Nicolassalazar-pro/desktop-robot/body models/README.md

# Desktop Robot CAD source

This directory contains the editable and printable mechanical design for the
Desktop Robot chassis:

- native Autodesk Fusion archives (`.f3d`)
- printable mesh exports (`.stl`)
- the assembled print project (`.3mf`)

## License notice

Copyright (c) 2025-2026 Nick Salazar.

These project-authored hardware design files are licensed under the
**CERN Open Hardware Licence Version 2 - Strongly Reciprocal
(CERN-OHL-S-2.0)**.

Full license text:
[`../LICENSES/CERN-OHL-S-2.0.txt`](../LICENSES/CERN-OHL-S-2.0.txt)

Source location:
<https://github.com/Nicolassalazar-pro/desktop-robot/tree/main/body%20models>

If you convey a modified design or a product made from it, follow the source,
notice, and reciprocity requirements in CERN-OHL-S-2.0.

## Fusion project archive

`Tank - Fusion Source/` contains the six native designs from the original
Fusion project:

- Buttons
- Head Mount Clip
- robot stand
- Screen Head Mount 1
- Screen Head Mount 2
- Support Bar
