Nicolassalazar-pro/desktop-robot/datasheets/Board_Hardware_Callouts.jpg

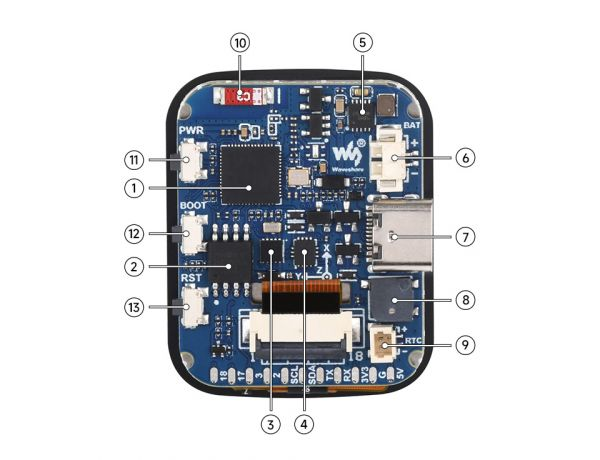
datasheets/Board_Hardware_Callouts.jpg
