Nicolassalazar-pro/desktop-robot/tools/assets/official-garage/horizontal_black.png

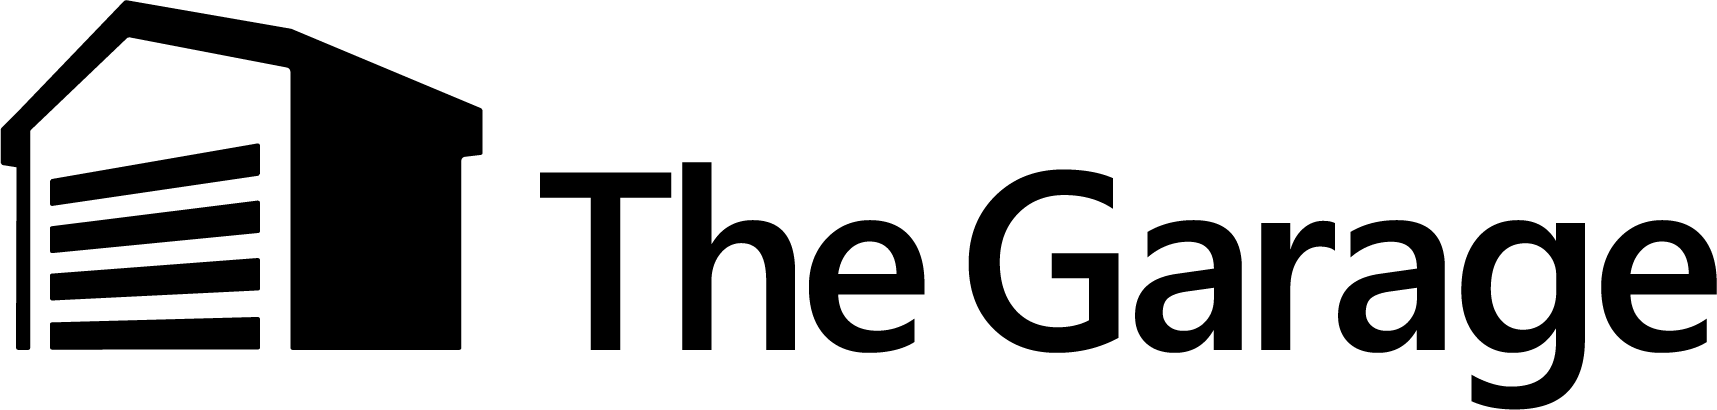
tools/assets/official-garage/horizontal_black.png
