Nicolassalazar-pro/desktop-robot/tools/assets/official-garage/vertical_black.png

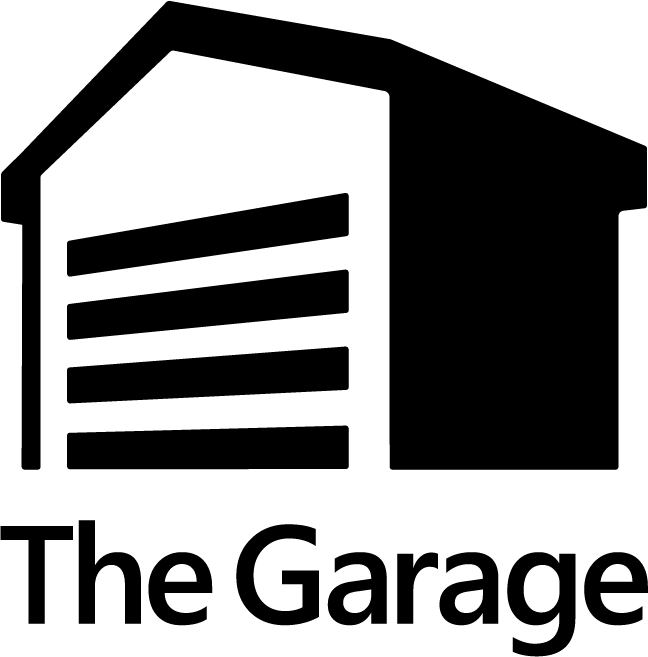
tools/assets/official-garage/vertical_black.png
