Nicolassalazar-pro/desktop-robot/body models/Full Parts Print.3mf

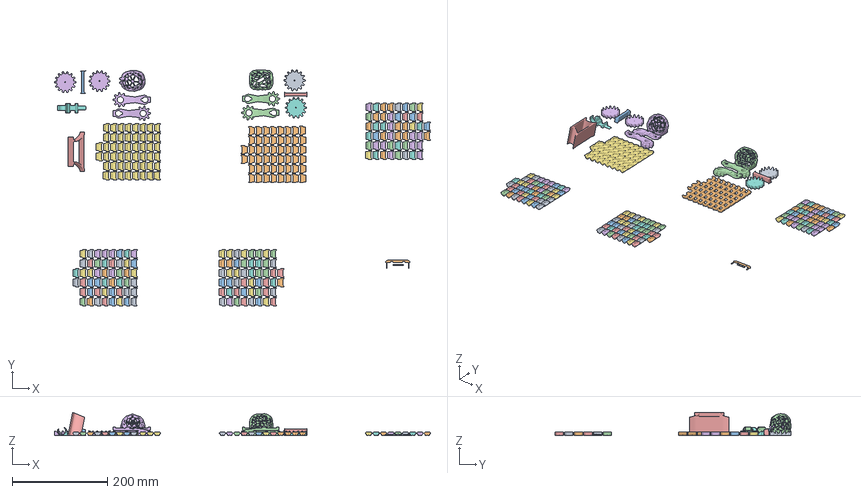
[picture p8: CAD file, 2026-08-07]
body models/Full Parts Print.3mf
788.2 x 495.1 x 49.0 mm
Drive Wheel.stl x 2
Track Organic Pads.stl x 50
Track Bar Pads.stl x 50
Track Choco Pads.stl x 50
Support Bar.stl x 2
Assembly x 4
Robot Stand.stl
Head Clip.stl
Buttons.stl
Support Bar 2.stl
