Nicolassalazar-pro/desktop-robot/body models/Support Bar 2.stl

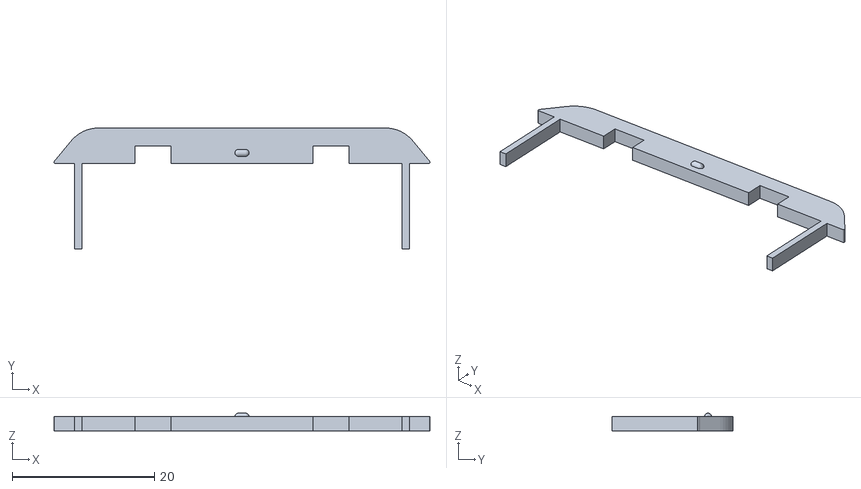
[picture p9: CAD file, 2026-08-07]
body models/Support Bar 2.stl
52.8 x 17.0 x 2.50
