Nicolassalazar-pro/desktop-robot/body models/Mesh Head 1.stl

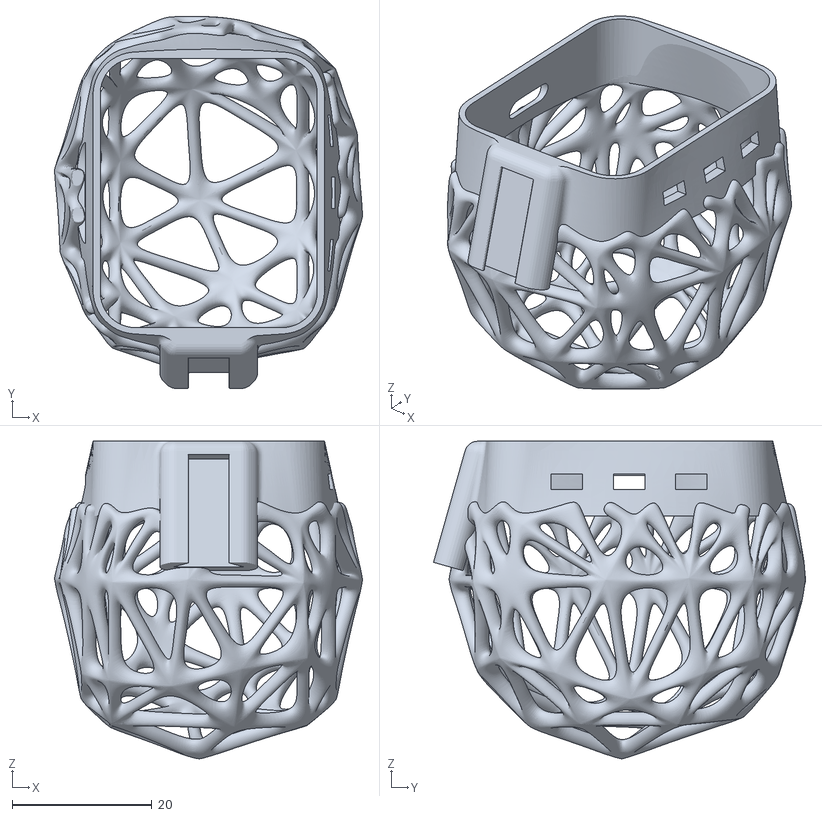
[picture p10: CAD file, 2026-08-07]
body models/Mesh Head 1.stl
44.0 x 53.2 x 45.4
