Nicolassalazar-pro/desktop-robot/body models/Buttons.stl

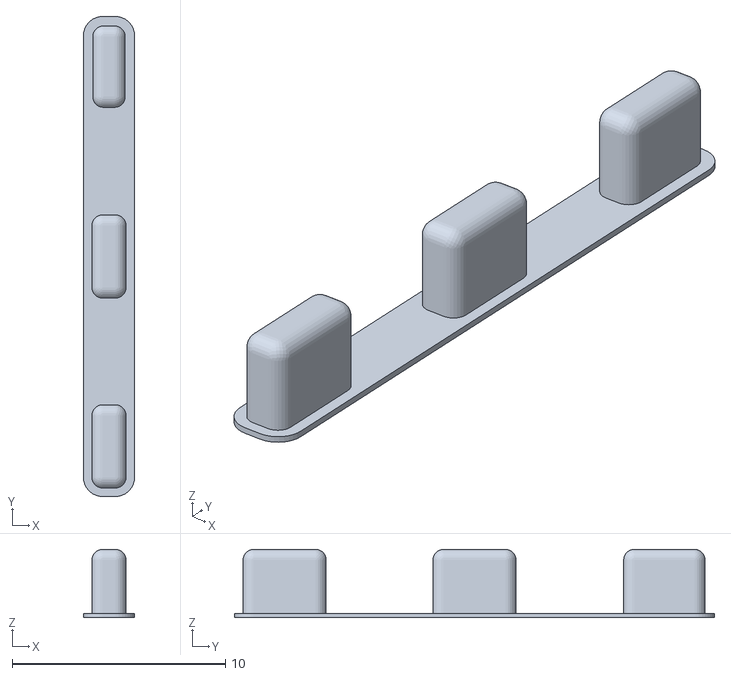
[picture p13: CAD file, 2026-08-07]
body models/Buttons.stl
2.40 x 22.5 x 3.20
