Nicolassalazar-pro/desktop-robot/body models/Track Choco Pads.stl

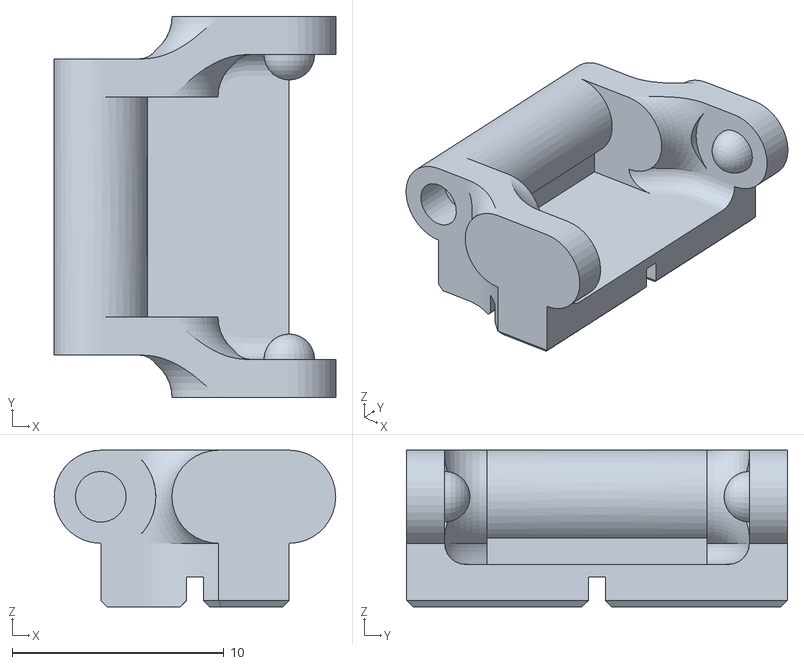
[picture p14: CAD file, 2026-08-07]
body models/Track Choco Pads.stl
13.3 x 18.0 x 7.40
