Nicolassalazar-pro/desktop-robot/body models/Drive Wheel.stl

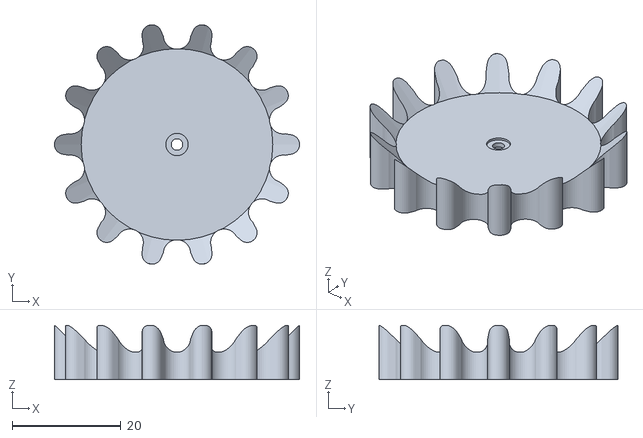
[picture p15: CAD file, 2026-08-07]
body models/Drive Wheel.stl
45.0 x 44.0 x 10.00
