Nicolassalazar-pro/desktop-robot/body models/Support Bar.stl

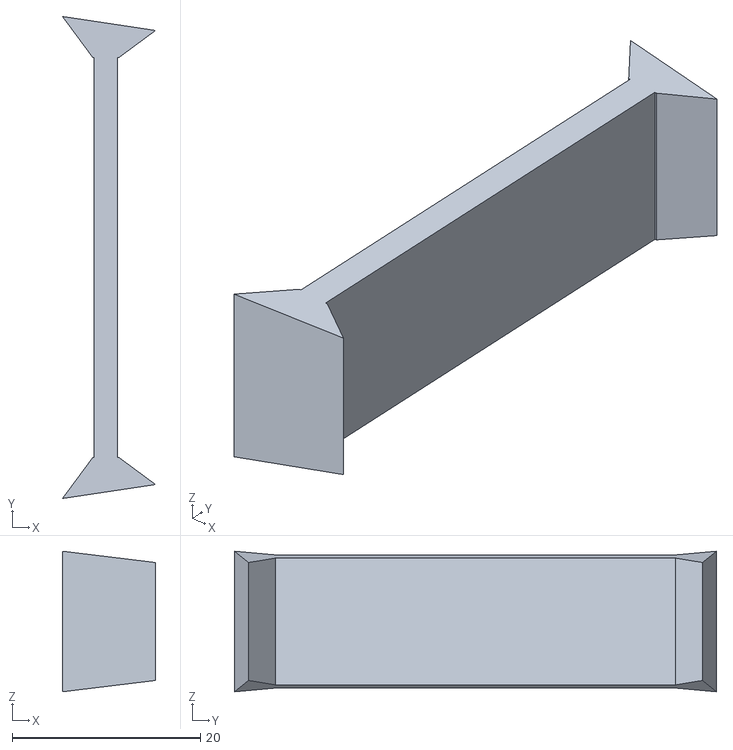
[picture p16: CAD file, 2026-08-07]
body models/Support Bar.stl
9.89 x 51.2 x 14.9
