Nicolassalazar-pro/desktop-robot/body models/Rear Road Wheel and Rail Guide.stl

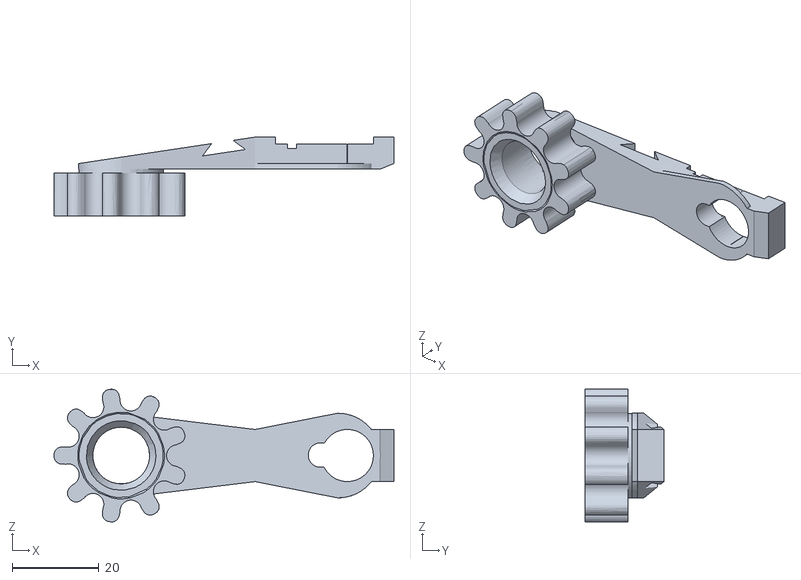
[picture p17: CAD file, 2026-08-07]
body models/Rear Road Wheel and Rail Guide.stl
78.3 x 18.2 x 30.6
