Nicolassalazar-pro/desktop-robot/body models/Head Clip.stl

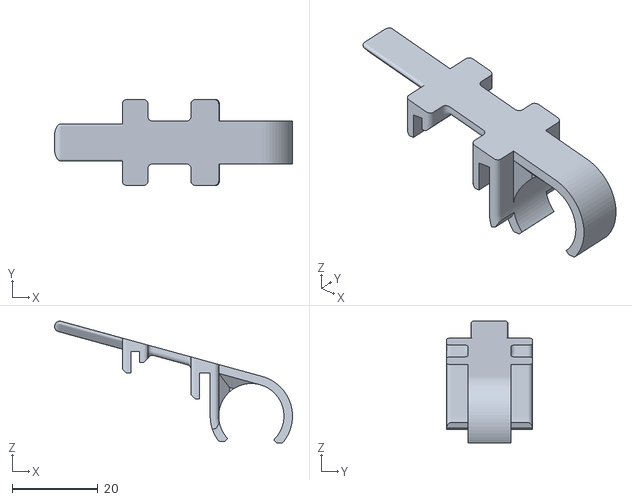
[picture p18: CAD file, 2026-08-07]
body models/Head Clip.stl
55.5 x 20.0 x 28.4
