Nicolassalazar-pro/desktop-robot/body models/Mesh Head 2.stl

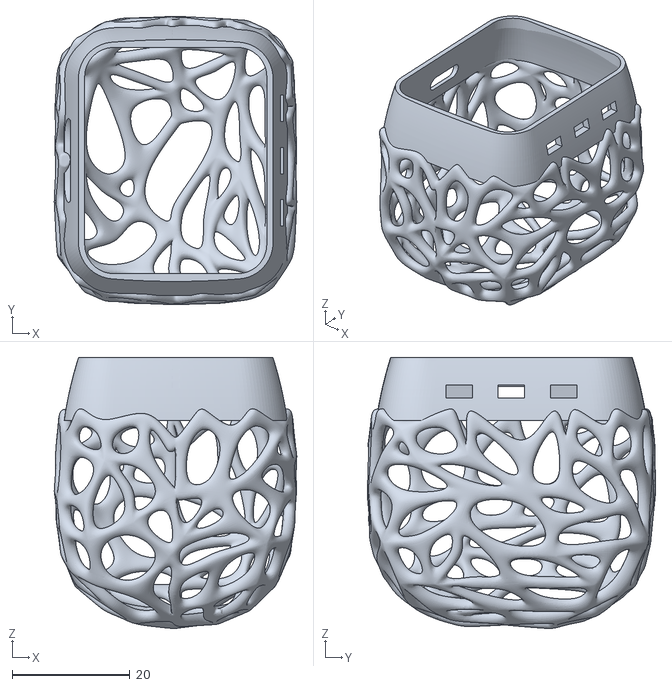
[picture p19: CAD file, 2026-08-07]
body models/Mesh Head 2.stl
41.3 x 49.0 x 46.1
