Nicolassalazar-pro/desktop-robot/body models/Robot Stand.stl

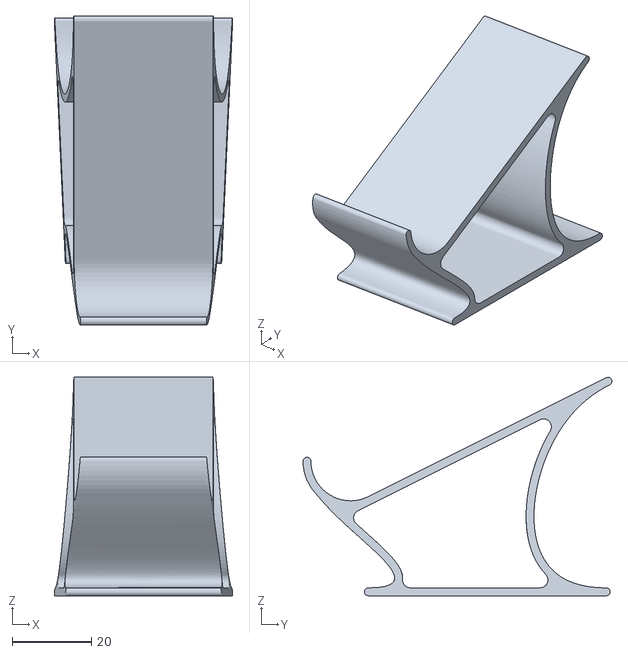
[picture p20: CAD file, 2026-08-07]
body models/Robot Stand.stl
45.0 x 77.9 x 55.1
