Nicolassalazar-pro/desktop-robot/(list of files, cad)

Other CAD files:
body models/Tank - Fusion Source/Buttons.f3d
body models/Tank - Fusion Source/Head Mount Clip.f3d
body models/Tank - Fusion Source/Screen Head Mount 1.f3d
body models/Tank - Fusion Source/Screen Head Mount 2.f3d
body models/Tank - Fusion Source/Support Bar.f3d
body models/Tank - Fusion Source/robot stand.f3d
