Nicolassalazar-pro/desktop-robot/src/override_html.h

// override_html.h
// Declaration for the PROGMEM-backed Override phone UI HTML payload.
// Definition lives in override_html.cpp so it does not clutter main.cpp.
#pragma once

#include <Arduino.h>

extern const char OVERRIDE_HTML[] PROGMEM;
