Nicolassalazar-pro/desktop-robot/tools/lcd_preview.py

"""Render the robot's LCD screens on the host, without flashing.

Every LCD layout bug so far has cost a full build-flash-look cycle, and one of
them (the step dots overlapping the password row by 2 px) was caught only
because the vertical budget happened to get checked by hand. This renders the
same screens to PNG so layout can be reviewed, and overlaps detected
automatically, before anything touches the panel.

It is a LAYOUT preview, not a pixel-exact emulator. That distinction matters:

  exact    screen size, element Y positions, text metrics, QR module count and
           scale, and therefore every overlap and every overflow -- which is
           the entire class of bug this exists to catch
  close    the GFX 5x7 glyph shapes are approximated by a system font
  ignored  colour depth (RGB565 banding) and SPI timing

The pull-down pairing sheet (src/sheet_transition.h) is previewed on the same
terms, one honest layer at a time:

  exact    kThresholdPct is parsed from the header, so if the commit point
           moves in firmware this filmstrip moves with it. The row-split
           composite (rows [0..sheetY) = card, rows [sheetY..H) = face) is
           the model spelled out in the header, not a re-modelled copy.
  close    the face is a labelled geometric placeholder, not the mascot
           bitmap; the pairing card is a labelled placeholder because the
           card's real layout is not yet in firmware. Both are drawn so they
           cannot be mistaken for the shipped artwork.
  ignored  rubber-band overshoot (only 0..100% is shown, not [-h/3..4h/3])
           and the release-by-projected-velocity decision (this shows sheet
           POSITION, not the gesture that produced it -- for that model see
           the header itself)

Positions and constants are PARSED FROM src/main.cpp, src/sheet_transition.h,
and platformio.ini rather than duplicated here, so the preview cannot silently
drift away from the firmware. If a y= value or a constexpr moves in the C++,
this follows it. If parsing fails it says so loudly instead of quietly
rendering a lie -- a preview that overstates itself is worse than none.

Usage:
    python tools/lcd_preview.py                    # render everything
    python tools/lcd_preview.py --sheet-only       # just the sheet filmstrip
    python tools/lcd_preview.py --out build/lcd    # choose output directory
    python tools/lcd_preview.py --check            # overlap check only, no PNGs

Exit code is non-zero if any screen has an overlap or overflows the panel, so
this can gate a build.
"""

from __future__ import annotations

import argparse
import pathlib
import re
import sys
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
