Nicolassalazar-pro/desktop-robot/(commit log)

2026-08-07 Baseline: working firmware at first commit
    The project had no version control until now. This commits the current
    working state as-is, before any refactoring, so every later change is
    reviewable and revertable.
    State at this commit:
    - ESP32-S3 Waveshare Touch-LCD-1.69 firmware; 16 LCD faces, 3 movement
    gestures, on-device mood-melody generator (happy/sad/confused), softAP
    web control app, IMU turn measurement with coast compensation.
    - 13 host test suites passing; pio build green.
    Recent debugging (see docs/ and HARDWARE.md):
    - LCD SPI dropped 80 -> 40 MHz. 80 MHz violates the ST7789V2 TSCYCW
    minimum of 16 ns (62.5 MHz ceiling), measured from the datasheet.
    - Added panel read-back vi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
2026-08-08 docs: recover 14 months of project history from 66 checkpoints
    The project history lived only in Copilot CLI session state. The current
    session had 3 of 67 checkpoints loaded, and that gap cost real time: two
    bugs were re-debugged from scratch this week that were already documented.
    PROJECT-HISTORY.md (1438 lines) distils session ee90215e:
    - Timeline across 28 eras, DeskNotif wire protocol through mood melodies
    - 26 decisions with the reasoning that produced them
    - 43 approaches ALREADY TRIED AND REJECTED, with why each failed
    - Measured hardware constants, flagged MEASURED vs ASSUMED
    - 8 open bugs, incl. full detail on the WiFi netstack 12308 fault
    - Working agreements, glossary, and a lis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
2026-08-08 fix(wifi): stop AP teardown corrupting the lwIP netif chain
    softAPdisconnect(wifioff=true) shuts the WiFi driver down inside the
    call, and that shutdown emits a spurious AP_START -> AP_STOP pair with:
    E wifi_init_default: netstack cb reg failed with 12289
    The driver is re-registering lwIP netif callbacks against a chain it is
    concurrently destroying. The result is an AP that beacons and hands out
    DHCP leases while routing nothing to AsyncWebServer - the phone joins,
    gets an IP, and every HTTP request times out.
    Open since checkpoint 062 (recorded there as 12308; same fault, the code
    varies). Two earlier attempts failed because both left wifioff=true:
    - removing WiFi.mode(WIFI_OFF) +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
2026-08-08 fix(serial): never write to USB CDC without FIFO space
    This is the black screen. It was never a display fault: the loop task
    blocked on a USB CDC write, stopped feeding the watchdog, and TASK_WDT
    reset the board ~5 s later. The screen going dark was the reset.
    The previous attempt gated periodic output on a host being attached.
    That was necessary but not sufficient, and the measurement that proved
    it is the useful part:
    port CLOSED, 150 s idle -> uptime 19s -> 176s, no reset
    port OPEN while I interacted -> reset
    An attached host is not necessarily a host that is reading. A script
    that opens the port, writes a command, sleeps, then reads leaves the
    FIFO to fill exactly as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
2026-08-08 build: pin dependencies exactly so the build is reproducible
    platformio.ini declared ^ and ~ ranges and PlatformIO has no lockfile, so
    the manifest did not determine what got built. Not theoretical - the tree
    on disk had already floated:
    declared ESPAsyncWebServer-esphome@^3.3.0 -> resolved 3.4.0
    declared ArduinoJson@^7.1.0 -> resolved 7.4.3
    declared GFX Library for Arduino@~1.3.7 -> resolved 1.3.9
    That matters here because three recent fixes depend on the exact
    AsyncTCP/AsyncWebSocket callback contract: refusing unauthorised upgrades
    at the HTTP handshake (closing inside WS_EVT_CONNECT crashed the board),
    reaping dead clients after 8 s (a phone leaving Wi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
2026-08-08 fix(safety): cancel a running gesture when drive control is force-reset
    RELY-3, and a regression I introduced earlier today.
    Fixing "gestures never move" required narrowing the abort gate in
    serviceMovementGesture from `state() != SafeOff` to only Active/Manual/
    Shutdown, because a connected-but-neutral web session sits at ArmedOff
    and was cancelling every gesture on its first tick.
    That over-corrected. resetDriveControl() puts the session in SafeOff, and
    SafeOff is no longer in the abort set - so a transport fault
    (MalformedControl, ProtocolFailure, TransportFailure, WS queue overflow)
    powered the rail down and the very next loop tick re-energised it, because
    serviceMovementGesture writes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
2026-08-08 fix(ui): make STOP a latched mode, and look like an emergency control
    DSGN-1 (critical) and DSGN-2, plus DSGN-7.
    STOP was a momentary write: zero curL/curR, send one frame. That does not
    survive the posture the user is actually in when they press it - one thumb
    still resting on a stick. The next pointermove reassigns curL/curR from the
    finger position and the 30 Hz sender re-arms drive within one tick, so the
    wheels stop for a single frame and then start again for no visible reason.
    STOP is now a mode:
    - stopLatched forces every outgoing control frame to zero, gated in
    sendCtrl itself so no stray handler can route around it
    - both stick pointermove handlers ignore a finger that was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
2026-08-08 fix(ws): never close a websocket client from the AsyncTCP callback
    RELY-1 and RELY-2.
    Closing a client from inside an AsyncTCP callback re-enters that client's
    own teardown. It is the pattern that crashed this board with INT_WDT and
    no backtrace, and the code comment above one of the call sites already
    named it "the prime suspect" and "a classic use-after-free".
    That was fixed for the AUTH path by refusing unauthorised upgrades at the
    HTTP handshake, before any client object exists. But auth is only one
    reason to reject an upgrade. Eight other close() calls remained on the
    AsyncTCP task: quarantined ingress, owner-busy, activation-faulted,
    enqueue-failure rollback, owner-token TOCTOU rollb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
2026-08-08 docs+fix: document the whole command surface, harden token compare
    DOCS-1/2/3/5/6, READ-2, RELY-7, RELY-8.
    `help` documented 25 of the 48 commands dispatchCommand actually handles.
    Everything built to diagnose this week's faults - lcdprobe, lcdpush,
    lcdbus, lcdspi, crash, sense - was reachable only by reading the source.
    All 24 missing commands are now listed and grouped.
    README:
    - the tethered-drive rule is now the first thing after the title, with
    the arm/unplug/press/read-back workflow spelled out. It was previously
    buried, and it is the rule most likely to damage hardware.
    - points at docs/PROJECT-HISTORY.md as the starting point, because two
    bugs were re-debugged this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
2026-08-08 perf: free 45 KB of internal RAM held for an off-by-default feature
    PERF-1.
    g_eyeRegionBackup was a static .bss array sized to the worst-case eye
    rectangle: 191 x 120 x 2 B = 45,840 bytes of INTERNAL SRAM. Confirmed from
    the linker map, not calculated:
    .bss._ZN12_GLOBAL__N_117g_eyeRegionBackupE 0xb310 = 45840
    Its only consumer is applyHeadSympathyShift(), which does nothing unless
    g_headShiftXDiv/YDiv are non-zero - and both default to 0. The feature is
    off until somebody types `headgain`. So the board permanently reserved
    45 KB of fast internal RAM, about 44% of everything it reported using, for
    a feature that was not running.
    Now allocated lazily in PSRAM on first use. PSRAM is th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
2026-08-08 fix(ws): stop the transport reaper crashing and killing live sessions
    Five defects, all on the AP/WebSocket path, all found by auditing my own
    changes rather than by patching symptoms. Four of the five were introduced
    earlier in this session BEFORE the git baseline, so they never appeared in
    any diff -- which is why incremental patching kept missing them.
    1. The stale-owner reaper's liveness clock was never armed.
    g_lastControlEventMs starts at 0 and was only written when a control
    FRAME arrived. Nothing set it when a client was ADMITTED. A client
    admitted at millis()=90000 was therefore instantly judged silent for
    90 s, and the reaper killed it on the very next loop pass, befo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
2026-08-08 fix(webapp): reconnect when telemetry goes silent + correct the RELY findings
    An open socket is not a working link.
    The firmware deliberately no longer closes a client whose transport ownership
    was revoked -- closing one from a stale data path was a use-after-free that
    reset the board (R45). But the web app only reconnected from `ws.onclose`, so
    with the close gone it had no way to notice it had been evicted: the socket
    stays open, every frame is ignored, and the UI sits on "live" forever.
    Reported as "im connected to the network but it wont respond to the controller".
    The robot streams telemetry at 5 Hz, so silence is a reliable liveness signal
    in the other direction. The app now tracks t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
2026-08-11 refactor: stop [DEBUG-DELETE] lying about shipping code, extract the web app
    READ-1, READ-3, READ-4. No functional change: build RAM and Flash are
    bit-for-bit identical to baseline and 13/13 host suites pass.
    READ-1 -- [DEBUG-DELETE] was being used with two contradictory meanings. On the
    mood-name overlay it accurately means "scratch, strip before ship". On the
    battery meter and the entire Override phone UI it wrapped permanent,
    user-facing, load-bearing features. One banner literally read "Remove this block
    + all matching // [DEBUG-DELETE] lines before ship." over the battery meter,
    which PROJECT-HISTORY fixes as permanent behaviour (D19). Directly below the
    Override banner sit the SHIPPED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
2026-08-11 refactor: table-dispatch the serial console, generate help from the table
    READ-5 / split Phase B. Mechanical move, no behaviour change.
    RAM 57,624 B -> 57,624 B (0 delta)
    Flash 1,198,917 B -> 1,196,845 B (-2,072 B)
    memory_order_* count 248 -> 248 (unchanged)
    help output byte-identical
    dispatchCommand was an ~1,830-line if/strcmp/return chain over 48 commands,
    with printHelp a hand-maintained duplicate of that list. It had already drifted
    badly once -- READ-2 found help was hiding ~17 real commands, including the
    load-bearing panel diagnostics that the person debugging a wedged screen most
    needs. Fixing the list by hand does not stop it drifting aga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
2026-08-11 wave 3: legible pairing screen, gated logs, 3 more suites, SEC-1
    Three parallel agents plus a read-only security pass.
    RAM 57,624 -> 57,640 B (+16, four new globals)
    Flash 1,196,845 -> 1,198,137 B (+1,292, mostly comments and the two screens)
    memory_order_* 248 -> 248 (unchanged)
    suites 14 -> 16 native, 210 -> 214 python, exit 0
    OPERATOR-FACING
    DSGN-6. The pairing screen showed a QR and nothing else, with SSID and password
    at 8-pixel type. Added an instruction line and put the credentials at size 2,
    with an adaptive fallback to size 1 if a longer SSID would overflow 240 px. The
    QR payload and scale are UNCHANGED -- it is v4-M at ~67% capacity and the QRCode
    libr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
2026-08-11 feat(lcd): tell the operator the pairing flow has two steps, and which way it moves
    Applies three new design-craft sections (6a swipe choreography, 6b motion under
    a watchdog, 18 behavioural psychology) to the QR pairing flow. Sources: Kole
    Jain's swipe-interaction and micro-animation breakdowns, and a UX-psychology
    survey covering choice overload, goal-gradient, reciprocity, IKEA effect, loss
    aversion and anchoring.
    THE ACTUAL PROBLEM
    Pairing is two steps -- join the Wi-Fi, then open the control page -- and nothing
    said so. You scanned the first code, the screen changed, and there was no way to
    tell whether that was the end of it or whether something else was expected. The
    goal-gradient l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
2026-08-11 diag: time the touch poll and the loop pass, in RTC memory
    Instrumentation only. No behaviour change, no fix attempted -- the TASK_WDT
    stall is being diagnosed before anything is built on top of the touch path.
    WHY THIS SHAPE
    The event resets the board, so anything in normal RAM dies with it, and the
    serial line is the one channel we already know can be complicit (a full USB CDC
    FIFO was itself a stall cause earlier this week). The counters therefore live in
    RTC memory beside the existing breadcrumb, and the failed run's numbers are
    printed at the NEXT boot before setup can overwrite them.
    Recording the touch poll AND the whole loop pass is the point. A watchdog reset
    proves only that the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
2026-08-11 diag: capture power and motion state at the worst touch poll
    Still instrumentation only. No fix, no behaviour change.
    The stall cannot be reproduced on demand, so the goal shifts: make the ONE
    occurrence we eventually get sufficient to settle the question, rather than
    merely confirming what we already know.
    THE HYPOTHESIS THIS TESTS
    Both watchdog resets happened UNTETHERED. That is the only state in which two
    things are simultaneously true: the board is on battery, and the servos actually
    run -- a tethered robot physically cannot complete a rotation, so movement is
    never really exercised on USB. A servo current spike sagging the rail could
    glitch the CST816T into holding SDA low, which wo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
2026-08-12 feat(lcd): pairing card that slides over the face, committing only on release
    The QR is now a SHEET, not a page transition. The face does not move; a card
    travels over it, tracks the finger 1:1, and nothing commits until the gesture
    completes. Built by five agents in parallel, then put through a code review and
    an interaction critique before it went near hardware.
    WHAT WAS WRONG BEFORE
    The previous attempt was a page SHIFT -- it moved the whole current screen and
    painted a hint band in the gap, which is why the operator saw the face sliding.
    Two concrete bugs behind "still not working with the QR code":
    1. The direction gate discarded the gesture: `if (onQr && dy > 0) dy = 0;`
    reje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
2026-08-12 feat(lcd): grabber bar, and the sheet becomes a shade you park
    Two changes. The second alters behaviour that shipped two hours ago rather than
    adding to it.
    1. GRABBER BAR
    Hidden while the sheet is closed and untouched -- the idle face is the robot's
    character and permanent chrome on it has a real cost, which is exactly why I did
    not add one unprompted when the interaction review asked for a signifier.
    It appears when a finger lands near it and gives up after 1 s if no drag
    follows, so a stray tap leaves no furniture behind. While the card moves it is
    welded to the card's BOTTOM edge, which is what turns it from
    decoration-that-happens-to-be-nearby into the thing being pulled.
    The reveal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
2026-08-12 tools: filmstrip tracks the grabber build, and caught a blank card
    Brought tools/lcd_preview.py up to the shipped interaction, which immediately
    paid for itself.
    WHAT THE PREVIEW NOW SHOWS
    - the grabber, welded to the card's bottom edge, exactly as serviceGrabber
    positions it (inset/width/height parsed from src/main.cpp)
    - the real card, mirroring drawSheetCard rather than a placeholder
    - the verb flipping "Pull down to pair" -> "Let go to pair" at the commit line
    - kCommitPct parsed from src/sheet_transition.h, replacing kThresholdPct,
    which no longer decides anything now that release parks
    Both frames at or past the commit line are marked, not just one, because commit
    is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
2026-08-13 Drop the establishing splash; stage sheet layers once per gesture
    The pull-down card is the real pairing screen now, so interposing an
    'Establishing Server...' splash painted over correct content and then
    redrew the identical QR a second later: QR -> splash -> QR, three
    screens for one action. On commit the card is handed to the panel as the
    live screen instead (handOffSheetQrToPanel). The full push there is not
    optional -- commit fires mid-drag, so the panel still shows face below
    the card edge at that instant, which the splash used to clean up
    incidentally. The chip-gesture fallback still splashes, since it arrives
    from FACE with no card staged.
    Two staging bugs found by testing:
    - The f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
2026-08-13 Add temp command: SoC temperature, clocks and power state
    'The board feels hotter' had no number behind it, and the candidate
    explanations (SPI clock, loop rate, CPU frequency, the charger) are not
    distinguishable by feel. This reports the on-die sensor alongside the
    things that could plausibly drive it.
    Measured on hardware: 54 C steady-state at 240 MHz on the idle face with
    the drive rail off and the battery charging -- normal for an S3 against a
    105 C junction rating. A first reading of 49 C taken seven seconds after
    reset was simply the die not yet warmed (loops=1), which is exactly the
    kind of thing this command exists to make visible rather than argued
    about.
    Conclusion recorded here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
2026-08-13 Attribute loop stalls to a segment, not to a bystander breadcrumb
    The whole-pass timer blamed ~500 ms on 'loop: power button', which is a
    digitalRead and three comparisons. The crumb was simply the last one
    written before the pass ended, so it named a bystander -- the same
    misattribution that made crash #5 look like the quarantine spin.
    breadcrumb() now measures the interval BETWEEN consecutive crumbs and
    records the worst pair, so a stall is attributed to a segment. Segments
    over 250 ms print live with both endpoints named. This immediately paid
    for itself: the 410 ms stall is 'ws ingress drained -> loop: power
    button', reproduced to within 150 us across runs, and lands exactly at
    WiFi.sof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
2026-08-13 Render the LCD screens natively on the host, pixel-exact
    Iterating on the LCD meant reflashing to look at it, and the offline
    preview we had (tools/lcd_preview.py) was a MODEL: it re-implemented the
    drawing in Python by parsing coordinates out of C++, approximated text
    with Consolas, and had already drifted -- it still rendered the
    'Pull down to pair' card months after drawSheetCard() was deleted.
    This compiles the REAL drawing path into a Windows exe instead. The key
    enabling fact is one the firmware already relies on: Arduino_Canvas with
    a nullptr output (as g_sheetCanvas uses) needs no SPI bus and no ST7789
    driver. Leaving ESP32 and __AVR__ undefined makes Arduino_GFX 1.3.9 fall
    through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
2026-08-13 Add a passive listener for the two open intermittent bugs
    Both remaining bugs are intermittent and both have been lost before
    simply because nothing was capturing when they fired: the TASK_WDT resets
    (now #9, all at 'loop: touch poll') and the joystick dropout, where
    control frames stop arriving and the 300 ms kControlTimeoutMs hides the
    stick behind WAIT NEUTRAL.
    tools/bot_watch.py reads the port passively and writes two files: a
    timestamped session log, and a short events log containing only lines
    worth looking at -- crash records, boot banners (including the new I2C
    bus-idle probe), WAIT_NEUTRAL timeouts, STALL segments, slow teardowns,
    bus recovery, and pairing failures. A recurrence no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
2026-08-13 Stop the watcher rebooting the board it is watching
    Attaching the listener reset the ESP32-S3 every time. Three boots in the
    capture -- watcher start, the pause/resume test, and a restart -- each
    reporting reset reason UNKNOWN(0) with the breadcrumb at 'loop: demo
    step', which is neither a TASK_WDT nor the touch-poll signature. Those
    were reported as crashes by the operator, and they were mine.
    Cause: pyserial asserts DTR when it opens a port, and the code deasserted
    it immediately afterwards. On ESP32-S3 native USB CDC that
    assert-then-deassert transition is the auto-reset pattern. Configuring
    dtr/rts on an unopened Serial() and opening after leaves the lines alone.
    Verified: the watcher n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
2026-08-13 Wait for the port to actually free before flashing
    The wrapper dropped the PAUSE sentinel then slept a flat 2 s, which
    raced: the watcher can be blocked in a 1 s readline when the sentinel
    appears, and on Windows the handle lingers briefly after close. The
    upload failed with 'Access to the path COM4 is denied'.
    Now it probes the port until it opens (up to ~6 s) and reports a clear
    error if something other than the watcher is holding it.
2026-08-13 Add MCU display UI tooling landscape study
    Six parallel research threads on whether there is a real gap in tooling
    for iterating UI on a microcontroller display, prompted by having to
    build a preview harness by hand for this repo.
    Headline: the hypothesis we set out to test -- that desktop preview
    tooling exists for retained-mode frameworks but is absent for the
    immediate-mode direct-draw ecosystem -- is FALSE as stated. LovyanGFX is
    immediate-mode and ships a first-party in-tree SDL2 desktop backend,
    autoselected by the same autodetect header used on hardware, documented
    for Windows, with mouse-as-touch. An existing sketch runs on the desktop
    with about seven added lines.
    It is true only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
2026-08-13 Correct two errors in the tooling landscape study
    Both found by verifying primary sources instead of trusting the threads.
    1. Star counts were wrong, and a conclusion rested on them. T6 argued
    'market failure by absence of demand' from GUIslice-Builder having 239
    stars. GitHub API: GUIslice has 1,360 stars / 224 forks (pushed
    2026-07-14) and Lopaka has 1,705 / 114 (pushed 2026-06-28). Neither
    archived, both active. Those are respectable numbers for niche
    developer tooling, so the 'nobody cares' reading is materially weaker
    than argued. What survives is narrower: nobody has built a business
    here, and the free tools have not become defaults.
    2. 'Nothing round-trips' was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
2026-08-14 Add offline UI development: WASM panel preview + web app simulator
    Makes both halves of the robot's interface runnable with no robot attached.
    LCD preview (tools/web_preview, port 8770)
    ------------------------------------------
    Compiles the panel to WebAssembly from the real firmware sources, replacing
    "flash to device" for UI work: edit src/screens.cpp -> build.ps1 (~7 s) ->
    refresh the browser, instead of ~30 s plus plugging in the robot.
    It builds the SAME seven translation units the firmware builds, so there is no
    second implementation to drift. That mattered before: the earlier
    tools/lcd_preview.py reimplemented the drawing in Python and kept rendering a
    drawSheetCard() that had alre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
2026-10-19 Add Tank Fusion source files
    Archive the six native F3D designs from the Fusion Tank project under body models so the editable source geometry is versioned alongside the exported print models.
    Copilot-Session: d619f14a-632e-43ed-9e8e-3ed394bcff69
2026-10-19 Prepare polished public release
    Replace the internal notebook-style front page with a product-led README, preserve the deep operating material as an engineering guide, add authentic LCD renders and an original hero, and document safety, architecture, preview tooling, contribution, and security workflows.
    Add the approved dual-license structure: MIT for project software and documentation, CERN-OHL-S-2.0 for CAD/hardware source, plus exact third-party notices and public-release licensing corrections.
    Sanitize current-machine paths and private-repository wording without touching the in-progress firmware and shutdown changes in the working tree.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
