Nicolassalazar-pro/desktop-robot/(notices)

Notices in the files:
README.md:
License: MIT + CERN-OHL-S-2.0
